BaaBaaGoat/AESAdiy/TRUnit/README.md

# 功能

- 2级放大+移相器
- 移相器最小分度值45°
- 发射放大增益40db 接收增益20db（标称) 
- 发射功率26dbm（标称) 
- 每张板子有2个阵元 相移可独立控制
  - 每个阵元包括2个相移相同的辐射体，目的是降低垂直方向的辐射角

# 生产工艺

- 嘉立创7628工艺
- 板厚1.6mm
-  嘉立创SMT
