BaaBaaGoat/AESAdiy/(list of files, drawings)

Other design files:
Antenna/production/1.PcbDoc
PowerDivider/PowerDivider.PcbDoc
TRUnit/PCB1.PcbDoc
TRUnit/PCB_Project.PrjPcb
TRUnit/PcbLib1.PcbLib
TRUnit/Sheet3.SchDoc
